ArkadiuszChorian/LedFightGame/README.md

# LED Fight Game

Projekt o nazwie „LED Fight”, to autorska gra zręcznościowa dla dwóch osób. Realizacja sprzętowa opiera się przede wszystkim o mikrokontroler Atmega8 oraz rejestry przesuwne. Implementacja powstała w środowisku Atmel Studio w języku C. Zarówno pomysł jak i realizacja są rezultatem moich własnych koncepcji. Do projektu dołączona jest dokumentacja w formacie PDF. 

Data wykonania: 2014

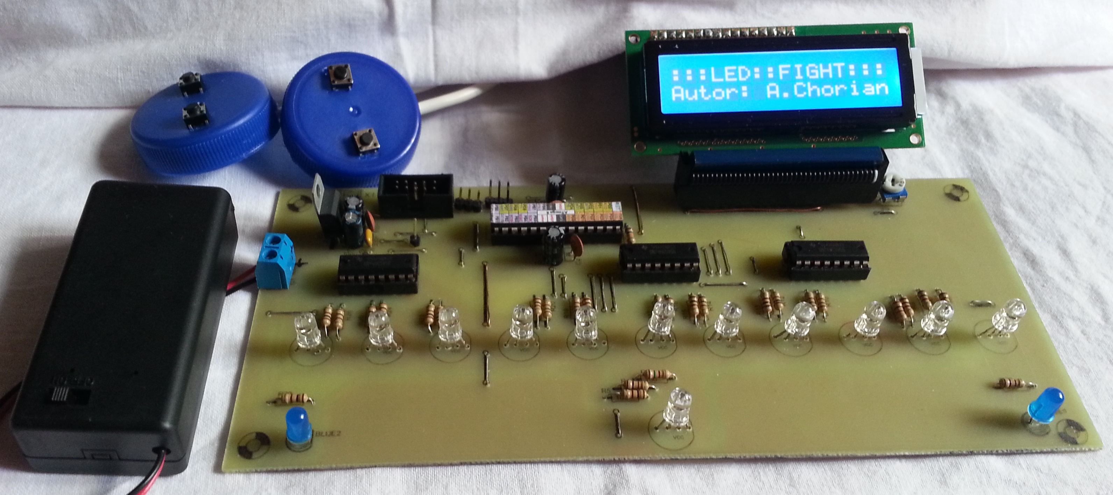
[picture p1: Photo.jpg]
